SagarSingh2004/Automatic-Mop-and-Vacuum-Robot/circuit_diagram.png

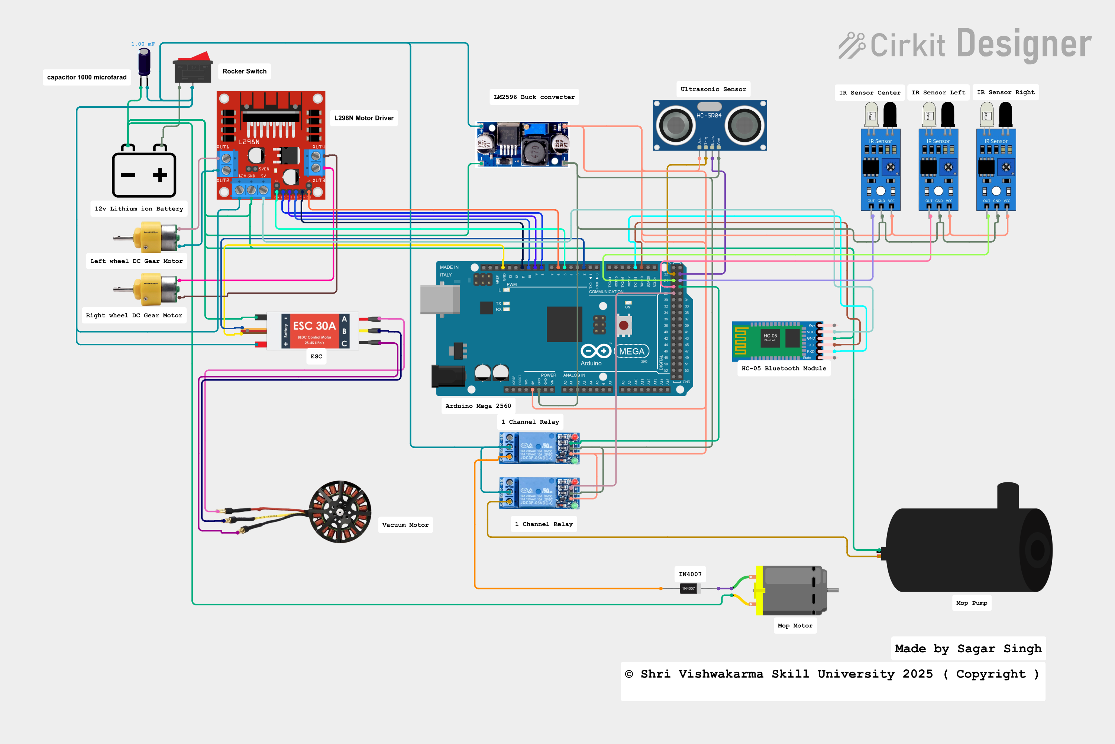
circuit_diagram.png
